navour/gripper/5_夹爪总程序id1slave1/doc/PC_Tool_寄存器大全.md

# PC_Tool 寄存器大全

本文按当前 `PC_Tool/3_gripper.py` 和固件 `User/Modbus/dm_modbus_bridge.c` 整理。通信协议为 Modbus RTU，默认串口参数由上位机界面填写，常用值为 `115200`，Slave 默认为 `1`。

## 1. Modbus 基本规则

| 项目 | 说明 |
| --- | --- |
| 读寄存器 | 功能码 `0x03`，读 Holding Registers |
| 写单个寄存器 | 功能码 `0x06` |
| 写多个寄存器 | 功能码 `0x10` |
| 寄存器宽度 | 每个寄存器 `16 bit`，大端字节序 |
| 32 位数 | 高 16 位寄存器在前，低 16 位寄存器在后 |
| CRC | Modbus CRC16，低字节在前 |
| 只读寄存器 | 固件会拒绝写入，返回异常码 `0x02` |

常用换算：

| 数据类型 | 换算 |
| --- | --- |
| `u16` | 原始无符号 16 位 |
| `s16` | 原始有符号 16 位，两补码 |
| `u32/s32` | 两个寄存器，高位在前 |
| `deg_x1000` | 角度 `deg * 1000`，例如 `30.00 deg -> 30000 -> 0x00007530` |
| `rad_x1000` | 弧度 `rad * 1000`，也就是 mrad |
| `Nm_x1000` | 力矩 `Nm * 1000`，例如 `0.120 Nm -> 120 -> 0x0078` |
| `B_x1000000` | 粘滞摩擦系数 `B * 1000000` |

## 2. 控制和配置寄存器

| 地址 | 名称 | 读写 | 含义 | 修改方法 |
| --- | --- | --- | --- | --- |
| `0x0000` | `DEV_ID` | 只读 | 设备 ID，固件默认 `0xD431` | 不可改 |
| `0x0001` | `FW_VER` | 只读 | 固件版本，高字节主版本，低字节次版本；当前固件初始化为 `0x010D`，即 v1.13 | 不可改 |
| `0x0010` | `MOTOR_ID` | 读写 | 电机 CAN ID，仅低 11 位有效 | 写入新 ID 后固件更新 `motor[Motor1].id` |
| `0x0011` | `MODE` | 读写 | 电机控制模式，PC 工具按钮写 `0`，即 MIT 模式 | `0x06` 写单寄存器 |
| `0x0012` | `ENABLE` | 读写 | 电机使能，`1` 使能，`0` 失能 | PC 工具“使能/失能”按钮 |
| `0x0013` | `CLEAR_FAULT` | 写触发 | 清除电机错误。写 `1` 后固件清错，若安全未锁存会重新使能 | PC 工具“清除错误” |
| `0x0014` | `UNIT_CFG` | 读写 | 目标单位配置。PC 工具写 `0x000B`：位置按 `deg_x1000`，速度按 `deg/s` | PC 工具“单位配置” |
| `0x0016` | `SAVE_ZERO` | 写触发 | 保存当前 AS5048A 位置为夹爪零点 | PC 工具“保存零点”或“一键标定” |
| `0x0017` | `SAVE_MOTOR_ZERO` | 写触发 | 保存当前电机位置为电机零点 | PC 工具“保存电机零点” |

示例：

```text
使能:     01 06 00 12 00 01 E8 0F
失能:     01 06 00 12 00 00 29 CF
MIT模式:  01 06 00 11 00 00 D9 CF
单位配置: 01 06 00 14 00 0B 88 09
清错:     01 06 00 13 00 01 B9 CF
```

## 3. 持久化状态寄存器

这一段由固件维护，只读。PC 工具“读持久化”会从 `0x0018` 连续读 8 个寄存器。

| 地址 | 名称 | 类型 | 含义 |
| --- | --- | --- | --- |
| `0x0018` | `PERSIST_VALID` | `u16` | Flash 中零点/比例参数是否有效，`1` 有效 |
| `0x0019~0x001A` | `PERSIST_LOADED_POS` | `s32 rad_x1000` | 已加载的 AS5048A 零点绝对角，单位 mrad |
| `0x001B` | `PERSIST_LOADED_SCALE` | `u16 x1000` | 电机位置到夹爪角度比例，例如 `26500 -> 26.5` |
| `0x001C` | `PERSIST_LAST_SAVE_ST` | `u16` | 最近一次保存状态码 |
| `0x001D` | `PERSIST_SAVE_OK_CNT` | `u16` | 保存成功次数 |
| `0x001E~0x001F` | `PERSIST_BIAS_MRAD` | `s32 rad_x1000` | host/motor 映射 bias，单位 mrad |

示例：

```text
读持久化 0x0018 起 8 个寄存器:
01 03 00 18 00 08 C4 0B
```

## 4. 目标控制寄存器

PC 工具发送目标时，从 `0x0020` 起一次写 8 个寄存器。

| 地址 | 名称 | 类型 | 含义 | PC 输入换算 |
| --- | --- | --- | --- | --- |
| `0x0020~0x0021` | `V_DES` | `s32` | 目标速度 | 当前 `UNIT_CFG=0x000B` 下，直接填 `deg/s`，例如 `5 -> 5 deg/s` |
| `0x0022~0x0023` | `P_DES` | `s32 deg_x1000` | 目标夹爪位置 | `P(deg) * 1000` |
| `0x0024` | `KP_1_100` | `u16` | Kp | `Kp * 100` |
| `0x0025` | `KD_1_100` | `u16` | Kd | `Kd * 100` |
| `0x0026~0x0027` | `TFF` | `s32 Nm_x1000` | 前馈力矩 | 工具当前把输入转成整数；填 `50` 表示 `0.050 Nm` |

示例：发送 `V=5 deg/s, P=30 deg, Kp=0.2, Kd=0.2, TFF=0`：

```text
01 10 00 20 00 08 10
00 00 00 05
00 00 75 30
00 14
00 14
00 00 00 00
B0 97
```

如果用“开合度(%)”按钮，PC 工具不会直接写百分比寄存器，而是先按：

```text
目标角度 = 全开角 + ratio / 100 * (全闭角 - 全开角)
```

然后仍然写 `0x0020~0x0027`。

## 5. 压力安全寄存器

| 地址 | 名称 | 读写 | 类型 | 含义 |
| --- | --- | --- | --- | --- |
| `0x0030~0x0031` | `SAFE_SUM_TH` | 读写 | `u32` | 压力总和阈值 |
| `0x0032` | `SAFE_MAX_TH` | 读写 | `u16` | 单点最大压力阈值 |
| `0x0034` | `SAFE_UNLOCK` | 写触发 | `u16` | 写 `0xA55A` 清除压力锁存 |
| `0x0106` | `SAFE_FLAGS` | 只读 | bit flags | 压力安全状态 |
| `0x0107~0x0108` | `SAFE_SUM` | 只读 | `u32` | 当前压力总和 |
| `0x0109` | `SAFE_MAX` | 只读 | `u16` | 当前最大压力点 |

`SAFE_FLAGS` 位定义：

| 位 | 名称 | 含义 |
| --- | --- | --- |
| bit0 | `LATCHED` | 已锁存，固件会失能电机 |
| bit1 | `SUM_OVER` | 当前总和超过阈值 |
| bit2 | `MAX_OVER` | 当前最大值超过阈值 |
| bit3 | `ARMING` | 已写解锁命令，等待释放后重新允许夹持 |

示例：

```text
写阈值 sum=2500, max=200:
01 10 00 30 00 03 06 00 00 09 C4 00 C8 A5 88

读安全状态 0x0106 起 4 个寄存器:
01 03 01 06 00 04 A5 F4

解锁:
01 06 00 34 A5 5A 33 6F
```

注意：压力锁存后，固件会把 `ENABLE` 置 `0` 并切断电机力矩。必须先排查压力原因，再写 `0x0034=0xA55A`。

## 6. 力矩估算和夹紧保持参数

PC 工具“力矩接触估算 / 夹紧保持”读写 `0x0036` 起 18 个寄存器。界面只显示其中一部分；隐藏字段会先读出原值再整体写回，避免被清零。

| 地址 | 索引 | 名称 | 类型/换算 | 默认值 | 含义 | 如何修改 |
| --- | ---: | --- | --- | ---: | --- | --- |
| `0x0036` | 0 | `EST_TOR_TH` / `Th(Nm)` | `Nm_x1000` | `80` | 接触判定阈值，`0.080 Nm` | 改界面 `Th(Nm)` 后点 `Write` |
| `0x0037` | 1 | `EST_VEL_IDLE_TH` | `rad/s * 1000` | `50` | 低于该速度认为接近静止 | 原始寄存器/Raw 修改 |
| `0x0038` | 2 | `EST_ALPHA` | `x1000` | `100` | 力矩低通滤波系数，`0.100` | 原始寄存器/Raw 修改 |
| `0x0039` | 3 | `EST_BIAS_LEARN` | `x1000` | `10` | 零偏学习率，`0.010` | 原始寄存器/Raw 修改 |
| `0x003A` | 4 | `EST_FRIC_B` / `B` | `B * 1000000` | `47` | 粘滞摩擦系数 | 改界面 `B` 后点 `Write` |
| `0x003B` | 5 | `EST_COULOMB_POS` / `Tc+` | `Nm_x1000` | `250` | 正向库仑摩擦 | 改界面 `Tc+` |
| `0x003C` | 6 | `EST_COULOMB_NEG` / `Tc-` | `Nm_x1000` | `120` | 反向库仑摩擦 | 改界面 `Tc-` |
| `0x003D` | 7 | `EST_STATIC_POS` / `Ts+` | `Nm_x1000` | `120` | 正向静摩擦 | 改界面 `Ts+` |
| `0x003E` | 8 | `EST_STATIC_NEG` / `Ts-` | `Nm_x1000` | `80` | 反向静摩擦 | 改界面 `Ts-` |
| `0x003F` | 9 | `EST_VEL_SIGN_TH` / `Vsign` | `rad/s * 1000` | `40` | 速度方向判定阈值 | 改界面 `Vsign` |
| `0x0040` | 10 | `EST_CONTACT_DIR` / `Dir` | `s16` | `1` | 接触力矩方向，`1` 或 `-1`；`-1` 写成 `0xFFFF` | 改界面 `Dir` |
| `0x0041` | 11 | `DM_PMAX_MRAD` | `rad * 1000` | 电机参数 | 电机位置绝对限幅 PMAX | 改 `PMAX(rad)` 后点“写 PMAX 并保存” |
| `0x0042` | 12 | `DM_PMAX_APPLY` | `u16` | `0` | PMAX 应用/保存命令，非 0 触发；PC 用 `3` | 通常不要手写 |
| `0x0043~0x0044` | 13~14 | `EST_BASE_OPEN` | `s32 rad_x1000` | `-29.74 deg` | 全开端力矩 baseline 对应角 | 改 `BaseOpen(deg)` 或“记录当前为全开角” |
| `0x0045~0x0046` | 15~16 | `EST_BASE_CLOSE` | `s32 rad_x1000` | `0 deg` | 全闭端力矩 baseline 对应角 | 改 `BaseClose(deg)` 或“一键标定” |
| `0x0047` | 17 | `EST_GRIP_TH` / `GripTh(Nm)` | `Nm_x1000` | `120` | 夹紧保持阈值，达到后停止继续闭合 | 改界面 `GripTh(Nm)` |

关于 `GripTh`：

```text
寄存器: 0x0047
0x0078 = 120 -> 0.120 Nm
0x00B4 = 180 -> 0.180 Nm
```

单独把 `GripTh` 改为 `0.180 Nm`：

```text
01 06 00 47 00 B4 39 A8
```

读取整组力矩估算参数：

```text
01 03 00 36 00 12 25 C9
```

写 PMAX 为 `12.5 rad` 并保存：

```text
01 10 00 41 00 02 04 30 D4 00 03 39 6A
```

注意：`Tc+ / Tc- / Ts+ / Ts-` 在 PC 工具里按有符号 16 位显示和写入，但当前固件按 `u16 / 1000` 同步到估算器。实际使用建议填正值。

## 7. 基础反馈寄存器

| 地址 | 名称 | 类型/换算 | 含义 |
| --- | --- | --- | --- |
| `0x0100~0x0101` | `FB_POS` | `s32 rad_x1000` | 当前夹爪反馈角，PC 转成 degree 显示 |
| `0x0103` | `FB_ERR` | `u16` | 电机错误码，低 4 位有效 |
| `0x0104` | `FB_MOS_TEMP` | `u16 degC` | MOS 温度 |
| `0x0105` | `FB_ROTOR_TEMP` | `u16 degC` | 电机转子温度 |

电机错误码：

| 值 | 含义 |
| --- | --- |
| `0x0` | 正常 |
| `0x1` | 已使能 |
| `0x8` | 过压 |
| `0x9` | 欠压 |
| `0xA` | 过流 |
| `0xB` | MOS 过温 |
| `0xC` | 线圈过温 |
| `0xD` | 通信丢失 |
| `0xE` | 过载 |

示例：

```text
读位置 0x0100 起 2 个寄存器:
01 03 01 00 00 02 C5 F7

读温度 0x0104 起 2 个寄存器:
01 03 01 04 00 02 84 36
```

## 8. 力矩估算反馈寄存器

这些寄存器只读，用来观察力矩估算和接触状态。

| 地址 | 名称 | 类型/换算 | 含义 |
| --- | --- | --- | --- |
| `0x010A~0x010B` | `FB_TOR_RAW` | `s32 Nm_x1000` | 原始电机力矩 |
| `0x010C~0x010D` | `FB_TOR_FILT` | `s32 Nm_x1000` | 滤波后力矩 |
| `0x010E~0x010F` | `FB_TOR_EXT` | `s32 Nm_x1000` | 扣除摩擦后的外力矩估算 |
| `0x0110~0x0111` | `FB_FORCE` | `s32 x1000` | force proxy，当前第一版近似等于接触力矩缩放 |
| `0x0112` | `FB_CONTACT_FLAG` | `u16` | 瞬时接触标志，非 0 表示接触 |
| `0x0113~0x0114` | `FB_TOR_FRIC` | `s32 Nm_x1000` | 平滑后的摩擦力矩 |
| `0x0121~0x0122` | `FB_FRIC_RAW` | `s32 Nm_x1000` | 原始摩擦模型输出 |
| `0x0123~0x0124` | `FB_BASELINE` | `s32 Nm_x1000` | baseline 力矩 |
| `0x0125~0x0126` | `FB_CONTACT_RAW` | `s32 Nm_x1000` | 原始接触力矩 |
| `0x0127~0x0128` | `FB_CONTACT_NET` | `s32 Nm_x1000` | 扣 baseline 后的接触力矩 |
| `0x0129~0x012A` | `FB_VEL_EST` | `s32 rad/s * 1000` | 估算速度 |
| `0x012B~0x012C` | `FB_POS_EST` | `s32 rad_x1000` | 估算位置 |

PC 工具轮询 `0x010A` 起 11 个寄存器显示 `TorqueEst`，也会在完整反馈里读取 `0x0121~0x012C`。

## 9. AS5048A、电机调试和目标状态反馈

| 地址 | 名称 | 类型/换算 | 含义 |
| --- | --- | --- | --- |
| `0x0115~0x0116` | `FB_AS_ABS` | `s32 rad_x1000` | AS5048A 绝对角 |
| `0x0117` | `FB_AS_STATUS` | `u16` | bit0 为 `1` 表示 AS 状态 OK |
| `0x0118~0x0119` | `FB_MOTOR_POS` | `s32 rad_x1000` | 电机当前位置 |
| `0x011A~0x011B` | `FB_MOTOR_CMD` | `s32 rad_x1000` | 电机下发目标位置 |
| `0x011C~0x011D` | `FB_MOTOR_RAW` | `s32 rad_x1000` | 限幅前电机目标位置 |
| `0x011E` | `FB_MOTOR_PMAX` | `u16 rad_x1000` | 当前电机 PMAX |
| `0x011F` | `FB_MOTOR_CLAMP` | `u16` | 目标是否被 PMAX 限幅 |
| `0x0120` | `FB_GOAL_STATUS` | bit flags | 目标状态 |

`FB_GOAL_STATUS` 位定义：

| 位 | PC 显示名 | 含义 |
| --- | --- | --- |
| bit0 | `valid` | 已解析到有效目标 |
| bit1 | `bias` | host/motor bias 已就绪 |
| bit2 | `en` | 电机已使能 |
| bit3 | `latch` | 压力安全锁存 |
| bit4 | `block` | 压力安全阻止动作 |
| bit5 | `applied` | 目标已应用到电机 |
| bit6 | `as_bias` | bias 来自 AS5048A |
| bit7 | `saved_bias` | bias 来自持久化 |
| bit8 | `torque_hold` | 夹紧保持已触发 |
| bit9 | `hold_new` | 新保持状态标志 |

## 10. 压力分区反馈寄存器

压力分区从 `0x0130` 开始，每个分区占 5 个寄存器，共 6 个分区，因此范围是 `0x0130~0x014D`。

分区顺序：

| 分区序号 | 名称 |
| ---: | --- |
| 0 | `TOTAL` |
| 1 | `BE_SUM` |
| 2 | `BE_C` |
| 3 | `BE_D` |
| 4 | `BE_E` |
| 5 | `LE_C` |

每个分区 5 个寄存器布局：

| 偏移 | 字段 | 类型 | 含义 |
| ---: | --- | --- | --- |
| `+0` | `flags` | bit flags | bit0=`calibrated`，bit1=`contact` |
| `+1~+2` | `sum` | `u32` | 分区压力总和 |
| `+3` | `max` | `u16` | 分区最大压力点 |
| `+4` | `area` | `u16` | 超过单点接触阈值的面积计数 |

地址示例：

| 分区 | 起始地址 | 覆盖地址 |
| --- | --- | --- |
| `TOTAL` | `0x0130` | `0x0130~0x0134` |
| `BE_SUM` | `0x0135` | `0x0135~0x0139` |
| `BE_C` | `0x013A` | `0x013A~0x013E` |
| `BE_D` | `0x013F` | `0x013F~0x0143` |
| `BE_E` | `0x0144` | `0x0144~0x0148` |
| `LE_C` | `0x0149` | `0x0149~0x014D` |

PC 工具分两次轮询：先读前三组 `0x0130` 起 15 个寄存器，再读后三组 `0x013F` 起 15 个寄存器。

## 11. 常见修改入口

| 目标 | 推荐方法 | 实际寄存器 |
| --- | --- | --- |
| 使能/失能电机 | PC 工具按钮 | `0x0012=1/0` |
| 设置目标角度 | PC 工具 `P(°)` + “发送目标” | `0x0020~0x0027` |
| 设置开合度百分比 | PC 工具 `夹爪开合度(%)` + “发送开合度” | 先换算成角度，再写 `0x0020~0x0027` |
| 调压力保护阈值 | PC 工具 `SUM_TH/MAX_TH` + “写安全阈值” | `0x0030~0x0032` |
| 压力锁存后解锁 | PC 工具“解锁” | `0x0034=0xA55A` |
| 调接触判定阈值 | PC 工具 `Th(Nm)` | `0x0036` |
| 调夹紧保持阈值 | PC 工具 `GripTh(Nm)` | `0x0047` |
| 调摩擦参数 | PC 工具 `B/Tc/Ts/Vsign/Dir` | `0x003A~0x0040` |
| 改 PMAX | PC 工具 `PMAX(rad)` + “写 PMAX 并保存” | `0x0041=PMAX*1000, 0x0042=3` |
| 保存夹爪零点 | PC 工具“保存零点”或“一键标定” | `0x0016=1` |
| 保存电机零点 | PC 工具“保存电机零点” | `0x0017=1` |

## 12. Raw Hex 修改示例

### 12.1 只改 `GripTh`

目标：把夹紧保持阈值从 `0.120 Nm` 改成 `0.180 Nm`。

计算：

```text
0.180 * 1000 = 180 = 0x00B4
```

帧：

```text
01 06 00 47 00 B4 39 A8
```

### 12.2 写一组安全阈值

目标：`SUM_TH=2500`，`MAX_TH=200`。

寄存器：

```text
0x0030 = 0x0000
0x0031 = 0x09C4
0x0032 = 0x00C8
```

帧：

```text
01 10 00 30 00 03 06 00 00 09 C4 00 C8 A5 88
```

### 12.3 发送目标

目标：`V=5 deg/s, P=30 deg, Kp=0.2, Kd=0.2, TFF=0`。

寄存器：

```text
V   = 5      -> 00 00 00 05
P   = 30000  -> 00 00 75 30
Kp  = 20     -> 00 14
Kd  = 20     -> 00 14
TFF = 0      -> 00 00 00 00
```

帧：

```text
01 10 00 20 00 08 10 00 00 00 05 00 00 75 30 00 14 00 14 00 00 00 00 B0 97
```

## 13. 修改代码时看这里

PC 工具里寄存器常量集中在 `PC_Tool/3_gripper.py` 文件开头：

```python
REG_MODE = 0x0011
REG_ENABLE = 0x0012
REG_V_DES_H = 0x0020
REG_EST_TOR_TH = 0x0036
REG_EST_GRIP_TH = 0x0047
REG_FB_POS_H = 0x0100
```

Modbus 帧生成函数：

```python
mb_read_holding(slave, addr, qty)     # 0x03
mb_write_single(slave, addr, value)   # 0x06
mb_write_multi(slave, addr, regs)     # 0x10
```

常用写入函数：

| 函数 | 作用 |
| --- | --- |
| `cmd_enable()` / `cmd_disable()` | 写 `0x0012` |
| `cmd_send_goal()` | 写 `0x0020~0x0027` |
| `cmd_write_safe_th()` | 写 `0x0030~0x0032` |
| `cmd_read_estimator()` | 读 `0x0036~0x0047` |
| `cmd_write_estimator()` | 写 `0x0036~0x0047` |
| `cmd_write_dm_pmax_save()` | 写 `0x0041~0x0042` |

如果新增上位机参数，优先复用这些换算函数：

```python
i32_to_regs(value)
s32_from_regs(reg_hi, reg_lo)
deg_to_mdeg_regs(deg)
deg_to_mrad_regs(deg)
signed_u16_from_float_x1000(val)
```
