navour/gripper/(list of files, cad)

Other CAD files:
model/MODEL1.STEP
