navour/gripper/5_夹爪总程序id1slave1/User/Motor/dm_motor_ctrl.h

#ifndef __DM_MOTOR_CTRL_H__
#define __DM_MOTOR_CTRL_H__
#include "main.h"
#include "dm_motor_drv.h"

extern motor_t motor[num];

typedef union
{
	float f_val;
	uint32_t u_val;
	uint8_t b_val[4];
}float_type_u;

void dm_motor_init(void);

void read_all_motor_data(motor_t *motor);
void receive_motor_data(motor_t *motor, uint8_t *data);

#endif /* __DM_MOTOR_CTRL_H__ */
