navour/gripper/(commit log)

2026-09-10 Add dual gripper controller projects
    [friction_params_20260416_192855.txt]
2026-09-10 Add gripper STEP model with Git LFS
    [MODEL1.STEP]
