navour/gripper/(notices)

Notices in the files:
5_夹爪总程序id2slave2/Core/Src/app_freertos.c:
Copyright (c) 2025 STMicroelectronics.
All rights reserved.
This software is licensed under terms that can be found in the LICENSE file
